milesarmstrong/resurrecting-the-rabbit/reports/final/report/images/origganttone.pdf

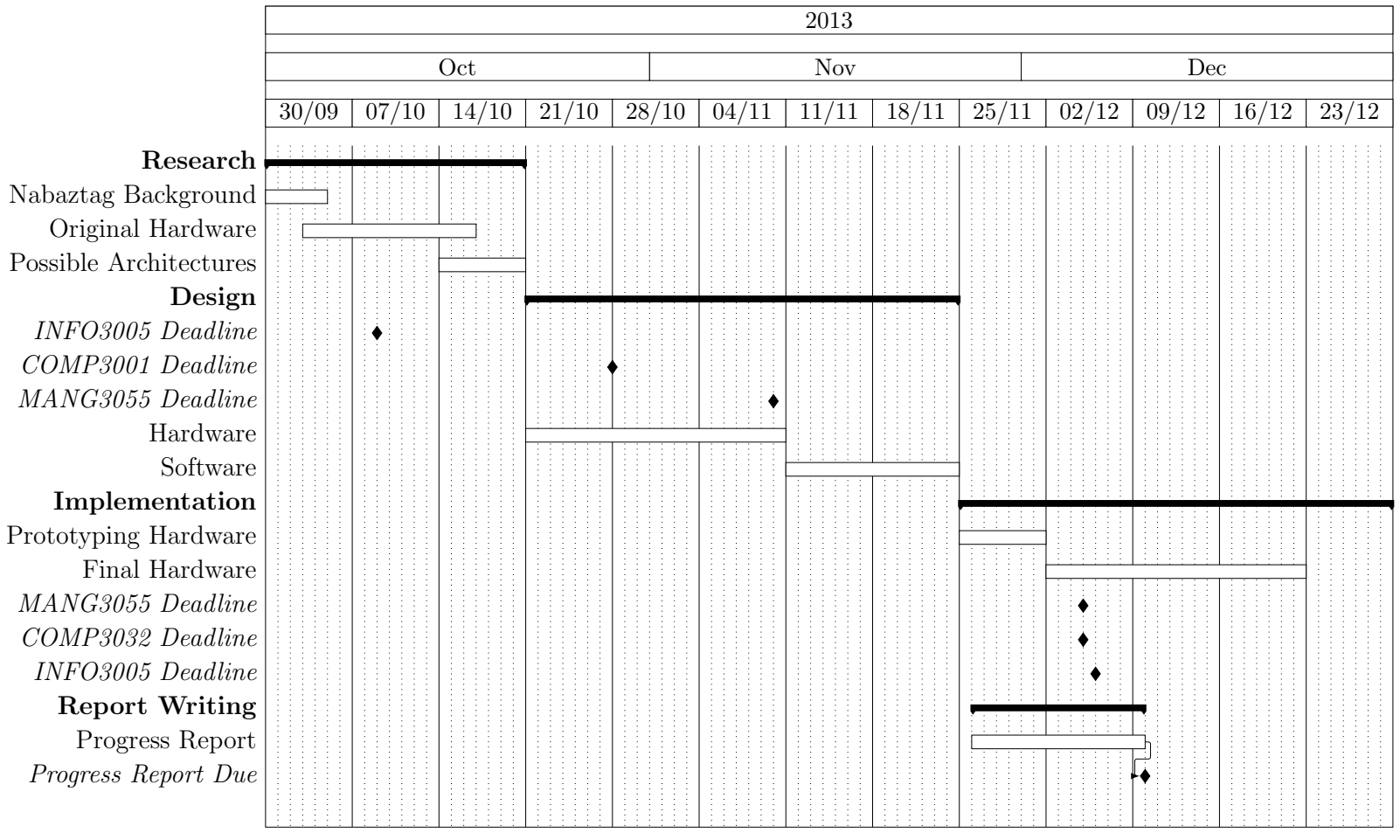
[picture p9: figure]
Oct; Nov; Dec; Research Nabaztag Background Original Hardware Possible Architectures Design INFO3005 Deadline COMP3001 Deadline MANG3055 Deadline Hardware Software Implementation Prototyping Hardware Final Hardware MANG3055 Deadline COMP3032 Deadline INFO3005 Deadline Report Writing Progress Report Progress Report Due
