milesarmstrong/resurrecting-the-rabbit/reports/final/report/images/origgantttwo.pdf

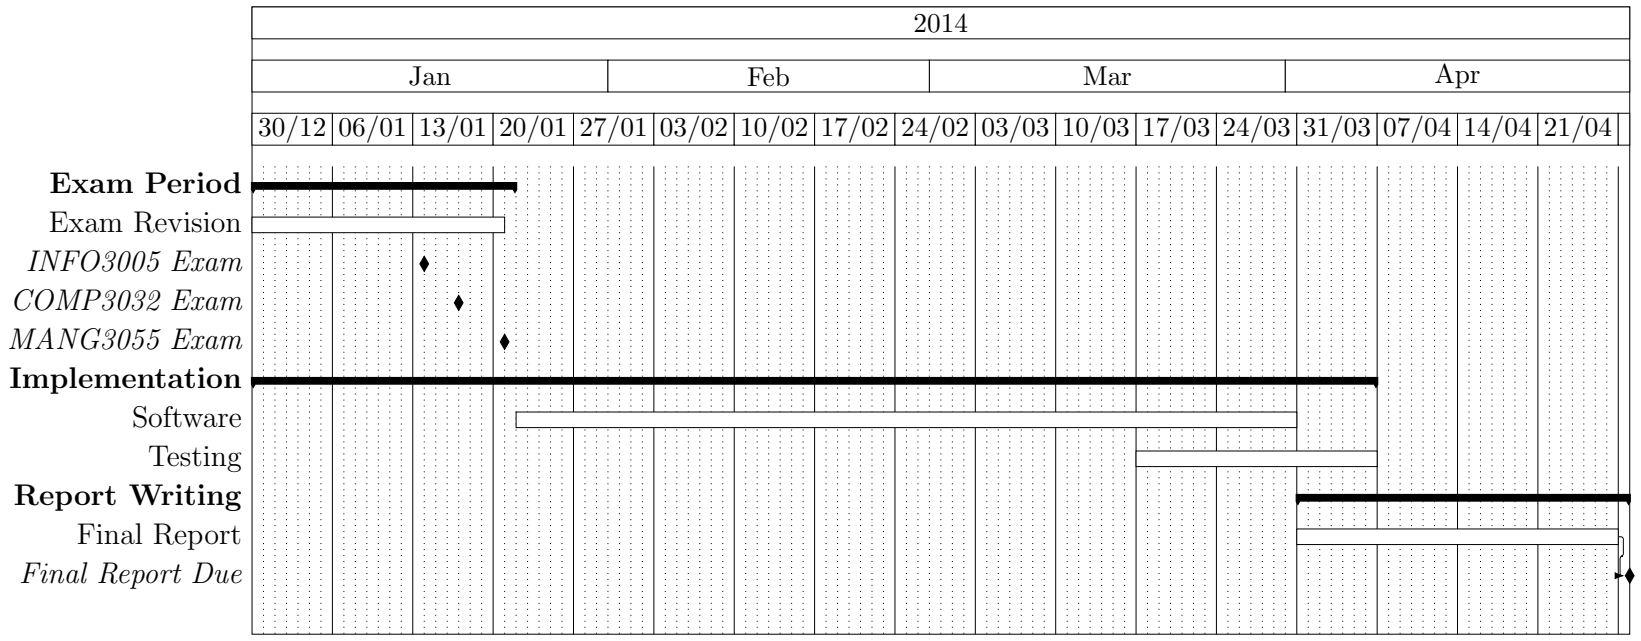
[picture p10: figure]
Jan; Feb; Mar; Apr; Exam Period Exam Revision INFO3005 Exam COMP3032 Exam MANG3055 Exam Implementation Software Testing Report Writing Final Report Final Report Due
