milesarmstrong/resurrecting-the-rabbit/reports/final/report/git_stats.csv

d | c
2014-02-02 | 3
2014-02-05 | 3
2014-02-06 | 4
2014-02-07 | 18
2014-02-08 | 3
2014-02-09 | 3
2014-02-10 | 2
2014-02-12 | 3
2014-02-14 | 1
2014-02-15 | 2
2014-02-16 | 9
2014-02-17 | 7
2014-02-18 | 3
2014-02-19 | 12
2014-02-20 | 8
2014-02-24 | 1
2014-02-25 | 3
2014-02-26 | 3
2014-02-28 | 9
2014-03-03 | 8
2014-03-04 | 2
2014-03-05 | 1
2014-03-08 | 5
2014-03-10 | 8
2014-03-11 | 2
2014-03-12 | 15
2014-03-15 | 8
2014-03-16 | 10
2014-03-23 | 3
2014-03-24 | 3
2014-03-25 | 4
2014-03-26 | 2
2014-03-30 | 1
2014-03-31 | 4
