milesarmstrong/resurrecting-the-rabbit/reports/final/report/images/githubgraph.png

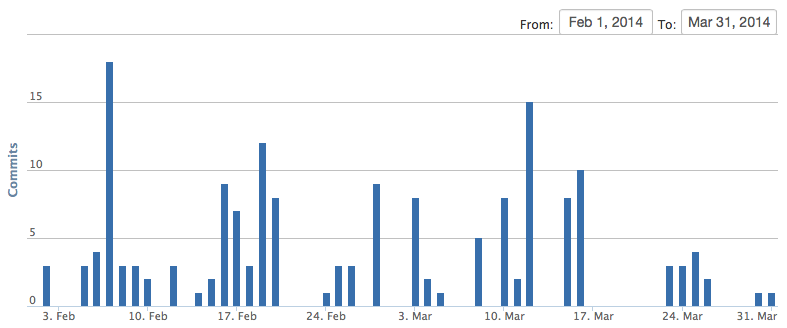
reports/final/report/images/githubgraph.png
