milesarmstrong/resurrecting-the-rabbit/reports/final/report/images/indexpage.png

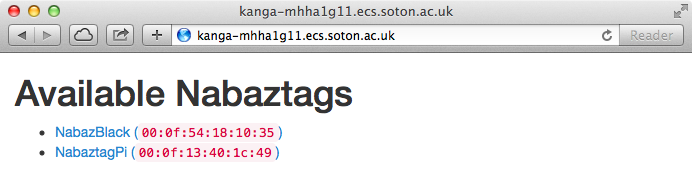
reports/final/report/images/indexpage.png
