milesarmstrong/resurrecting-the-rabbit/reports/final/report/images/irencoder.jpg

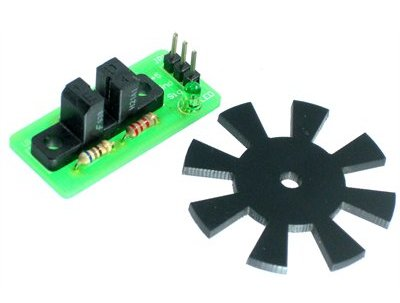
reports/final/report/images/irencoder.jpg
